DeepakRajasekaran/PowerDistributionBoard/docs/Technical_Assignment_2B.pdf

# Assignment 2b: 4S Battery Protection and Power Distribution Board

Author: Deepak Rajasekaran
Repository: https://github.com/DeepakRajasekaran/PowerDistributionBoard.git Document Revision: v1.1
Date: October 2026
EDA Suite: KiCad 9.0

## 1. Project Overview & Requirements

This report details the design and component selection for a 4S lithium-ion battery protection and power distribution board developed in KiCad. The board takes an unregulated battery input and routes power to two separate outputs:

1. Output 1 (Regulated 5V Rail): Provides a steady 5.0V at up to 3.0A continuous (15W) using a step-down buck switching regulator. This rail is intended for digital electronics such as flight controllers, single-board computers, and sensors. It features cycle-by-cycle overcurrent protection and automatic thermal shutdown.
2. Output 2 (Pass-Through Rail): An unregulated battery pass-through rated for 10.0A continuous (168W peak at full charge), designed to run high-power actuators, DC motors, or ESCs.

The board also includes front-end protection against short circuits, overcurrent, reverse battery connection, and inductive voltage spikes.

## 2. Power Architecture & Block Diagram

The board uses an input protection stage followed by two independent output branches. Power enters through an XT60 connector, passes through a primary 15A fuse, a bidirectional TVS diode, and a P-channel MOSFET reverse-polarity circuit. This creates an internal protected bus ( ).

From the internal bus, current splits into two separate fused paths:

The pass-through rail (Output 2) has its own 10A fuse and an 18V TVS clamp.
The 5V buck converter (Output 1) has a dedicated 3A branch fuse.

Fusing each output independently prevents a short circuit on the motor output from pulling down the 5V logic supply.

VSYS

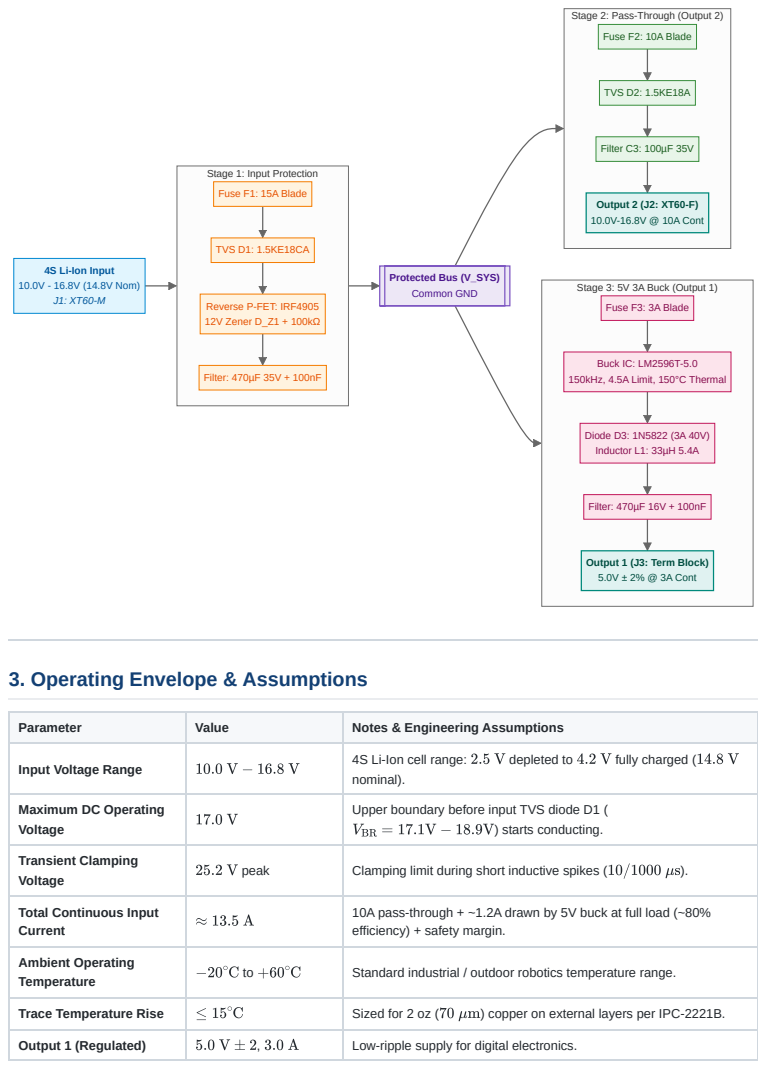
[picture p1: page 2]
Buck IC: LM2596T-5.0 150kHz, 4.5A Limit, 150°C Thermal; Diode D3: 1N5822 (3A 40V) Inductor L1: 33µH 5.4A; Filter: 470µF 16V + 100nF; TVS D2: 1.5KE18A; Filter C3: 100µF 35V; Output 2 (J2: XT60-F) 10.0V-16.8V @ 10A Cont; TVS D1: 1.5KE18CA; Reverse P-FET: IRF4905 12V Zener D_Z1 + 100kΩ; Filter: 470µF 35V + 100nF; Protected Bus (V_SYS) Common GND

Stage 2: Pass-Through (Output 2)
Fuse F2: 10A Blade

Stage 1: Input Protection
Fuse F1: 15A Blade

4S Li-Ion Input
10.0V - 16.8V (14.8V Nom)

Stage 3: 5V 3A Buck (Output 1)
Fuse F3: 3A Blade

Output 1 (J3: Term Block)
5.0V ± 2% @ 3A Cont

3. Operating Envelope & Assumptions

Parameter | Value | Notes & Engineering Assumptions

Input Voltage Range | 10.0 V − 16.8 V | 4S Li-Ion cell range: 2.5 V depleted to 4.2 V fully charged ( 14.8 V nominal).

Maximum DC Operating Voltage | 17.0 V | Upper boundary before input TVS diode D1 ( VBR = 17.1V − 18.9V ) starts conducting.

Transient Clamping Voltage | 25.2 V peak | Clamping limit during short inductive spikes ( 10/1000 μs ).

Total Continuous Input Current | ≈ 13.5 A | 10A pass-through + ~1.2A drawn by 5V buck at full load (~80% efficiency) + safety margin.

Ambient Operating Temperature | ∘C +60 ∘C −20 to | Standard industrial / outdoor robotics temperature range.

Trace Temperature Rise | ≤ 15 ∘C | Sized for 2 oz ( 70 μm ) copper on external layers per IPC-2221B.

Output 1 (Regulated) | 5.0 V ± 2 3.0 A , | Low-ripple supply for digital electronics.

Parameter | Value | Notes & Engineering Assumptions
Output 1 Ripple | < 30 mVp-p | Filtered using a 470µF electrolytic cap and a 100nF ceramic cap.
Output 2 (Pass-Through) | 10.0 V − 16.8 V , 10.0 A | High-power branch for DC motors and speed controllers.
Assembly Technology | 100% Through-Hole (THT) | Selected for easy assembly, field repairability, and sturdy mechanical mounting.

## 4. Circuit Design & Component Selection

### 4.1 Primary Fuse (F1)

I selected a 15A mini automotive blade fuse ( 0297015.WXNV ) mounted in a Keystone 3568 through-hole clip.

With both outputs running at full load, total continuous current is approximately 11.2A to 12.0A. A 15A rating provides roughly 25% to 30% margin over normal operating current, preventing nuisance blowing during startup surges while tripping quickly under short-circuit conditions. Blade fuses also offer very low resistance (around ), keeping voltage drop minimal.

### 4.2 Input Transient Suppressor (D1)

For overvoltage and transient suppression, the input uses a bidirectional TVS diode ( 1.5KE18CA ) rated for 1500W peak pulse power.

Standoff Voltage ( | ):
Breakdown Voltage ( | ): | ( | typical)
Clamping Voltage ( ): | at | peak
Because a 4S pack reaches | when fully charged, selecting an 18V TVS ensures that the diode stays
completely non-conducting during normal charging. If an inductive spike occurs from hot-plugging or motor switching, the diode clamps the spike well below the 35V/50V ratings of the capacitors and the 40V rating of the buck IC. If someone mistakenly connects a continuous 24V supply, D1 conducts heavily to ground and blows fuse F1, protecting the board.

### 4.3 Reverse-Polarity Protection (Q1, D_Z1, R_G1)

Connecting a battery backwards can instantly destroy electronics. While a standard series diode is the simplest solution, at 10A continuous it would drop 0.5V to 0.7V and dissipate:

This would generate excessive heat, require a bulky heatsink, and waste battery life.

Instead, I used an active high-side P-channel MOSFET switch ( IRF4905 in a TO-220 package). The IRF4905 has
an on-state resistance ( | ) of only | . At 10A continuous, conduction loss is:

The TO-220 package easily dissipates 2W in open air without a large heatsink.

Circuit Operation:

5 mΩ

VRWM | 15.3 V
VBR | 17.1 V − 18.9 V 18.0 V
VC | 25.2 V | 59.5 A

16.8 V

P = I × VF = 10 A × 0.6 V = 6.0 W

RDS(on) | 20 mΩ

P = I

| 2 × RDS(on) = (10 A)

2 × 0.020 Ω = 2.0 W

Normal Connection: When power is applied correctly, the gate is pulled to ground through a 100kΩ resistor
( | ). This gives a negative gate-to-source voltage ( | ), turning the MOSFET fully on.
Gate Protection: Because the maximum gate-to-source rating of the IRF4905 is | , a 12V Zener diode
( | : 1N4742A ) clamps | to -12V. This protects the thin gate oxide when the battery is at its 16.8V
maximum.
Reverse Connection: If the battery polarity is reversed, the gate is positive relative to the source (
), keeping the MOSFET off. The internal body diode is reverse-biased, completely blocking reverse current.

### 4.4 Stage 2: Pass-Through Output (F2, D2, C3)

The pass-through output (Output 2) connects through an independent 10A mini blade fuse ( F2 ).

Selective Coordination: Placing F2 on the pass-through channel ensures that if a motor shorts out, only F2 blows. The main 15A input fuse (F1) remains intact, keeping the 5V logic supply running without interruption. Inductive Clamp (D2): A unidirectional TVS diode ( 1.5KE18A ) across Output 2 absorbs inductive flyback voltage spikes caused by motor winding inductance when loads switch off suddenly.
Decoupling (C3): A 100µF 35V low-ESR electrolytic capacitor smooths voltage dips caused by motor startup surges.

### 4.5 Stage 3: Regulated 5V 3A Buck Converter (U1, D3, L1, C_OUT)

To supply 5.0V at up to 3.0A, I chose the Texas Instruments LM2596T-5.0 switching regulator in a 5-pin TO-220 package.

Switching Frequency: Operates at a fixed 150kHz, allowing the use of a reasonably small 33µH inductor while maintaining conversion efficiency above 80%.
Built-in Protection: The IC includes cycle-by-cycle current limiting set at 4.5A typical, as well as automatic thermal shutdown at 150°C.
Branch Fuse (F3): A 3A fast-acting blade fuse protects the buck stage against catastrophic regulator failure.
Duty Cycle Calculations: The duty cycle | of the buck regulator varies with input voltage:
Using | for the Schottky diode and | for the internal switch:
At nominal battery voltage ( | ):
At fully charged battery ( | ):
| During a 25V transient clamp:

Because the LM2596 can operate down to duty cycles below 5%, the closed-loop feedback maintains an exact 5.0V output across the entire input range and during transient voltage spikes.

Inductor Selection (L1): I selected a 33µH, 5.4A through-hole toroidal inductor ( 2100HT-330-V-RC ). The peak-topeak inductor ripple current at 14.8V nominal input is:

Peak inductor current at full 3A load is:

RG1 | VGS ≈ −VIN

±20V

DZ1 | VGS

VGS ≥ 0V

D

D =

VOUT + VD

VIN − VSAT + VD

VD = 0.45V | VSAT ≈ 1.1V

14.8V D ≈

5.0+0.45
14.8−1.1+0.45 = 5.45
14.15 ≈ 38.5

16.8V D ≈ 5.45
16.15 ≈ 33.7

D ≈ 5.45
24.35 ≈ 22.4

ΔIL =

(VIN − VOUT) ⋅ D

fsw ⋅ L1

=

(14.8 − 5.0) V × 0.385

150 kHz × 33 μH

≈ 0.76 Ap-p

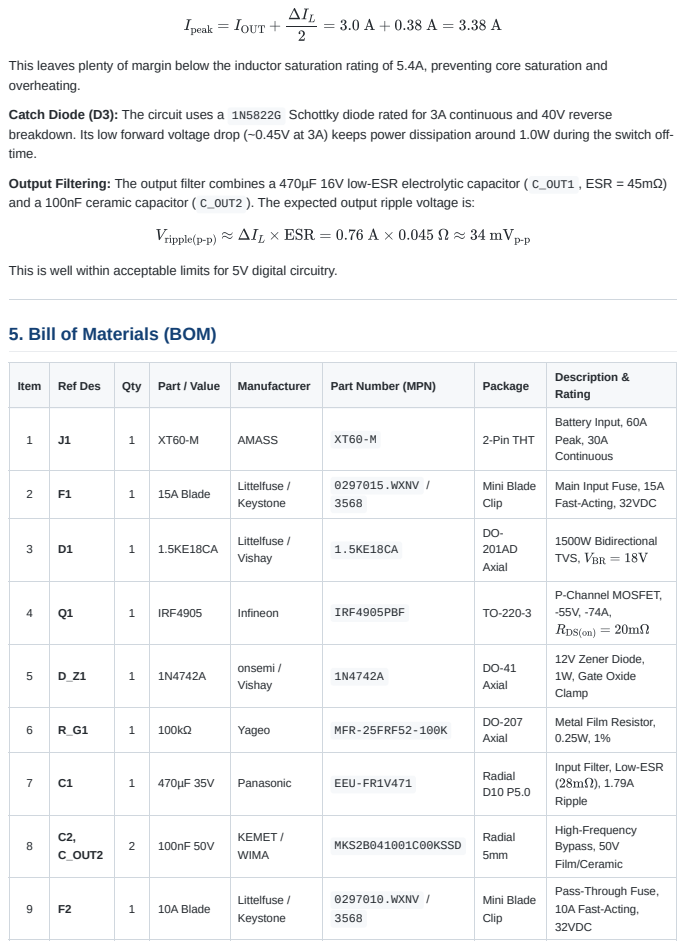
[picture p2: page 5]
Ipeak = IOUT +; ΔIL

This leaves plenty of margin below the inductor saturation rating of 5.4A, preventing core saturation and
overheating.

Catch Diode (D3): The circuit uses a 1N5822G Schottky diode rated for 3A continuous and 40V reverse
breakdown. Its low forward voltage drop (~0.45V at 3A) keeps power dissipation around 1.0W during the switch off-
time.

Output Filtering: The output filter combines a 470µF 16V low-ESR electrolytic capacitor ( C_OUT1 , ESR = 45mΩ)
and a 100nF ceramic capacitor ( C_OUT2 ). The expected output ripple voltage is:

Vripple(p-p) ≈ ΔIL × ESR = 0.76 A × 0.045 Ω ≈ 34 mVp-p

This is well within acceptable limits for 5V digital circuitry.

5. Bill of Materials (BOM)

Item | Ref Des | Qty | Part / Value | Manufacturer | Part Number (MPN) | Package | Description & Rating

1 | J1 | 1 | XT60-M | AMASS | XT60-M | 2-Pin THT | Battery Input, 60A Peak, 30A Continuous

2 | F1 | 1 | 15A Blade | Littelfuse / Keystone | 0297015.WXNV / 3568 | Mini Blade Clip | Main Input Fuse, 15A Fast-Acting, 32VDC

3 | D1 | 1 | 1.5KE18CA | Littelfuse / Vishay | 1.5KE18CA | DO-201AD Axial | 1500W Bidirectional TVS, VBR = 18V

4 | Q1 | 1 | IRF4905 | Infineon | IRF4905PBF | TO-220-3 | P-Channel MOSFET, -55V, -74A, RDS(on) = 20mΩ

5 | D_Z1 | 1 | 1N4742A | onsemi / Vishay | 1N4742A | DO-41 Axial | 12V Zener Diode, 1W, Gate Oxide Clamp

6 | R_G1 | 1 | 100kΩ | Yageo | MFR-25FRF52-100K | DO-207 Axial | Metal Film Resistor, 0.25W, 1%

7 | C1 | 1 | 470µF 35V | Panasonic | EEU-FR1V471 | Radial D10 P5.0 | Input Filter, Low-ESR ( 28mΩ ), 1.79A Ripple

8 | C2, C_OUT2 | 2 | 100nF 50V | KEMET / WIMA | MKS2B041001C00KSSD | Radial 5mm | High-Frequency Bypass, 50V Film/Ceramic

9 | F2 | 1 | 10A Blade | Littelfuse / Keystone | 0297010.WXNV / 3568 | Mini Blade Clip | Pass-Through Fuse, 10A Fast-Acting, 32VDC

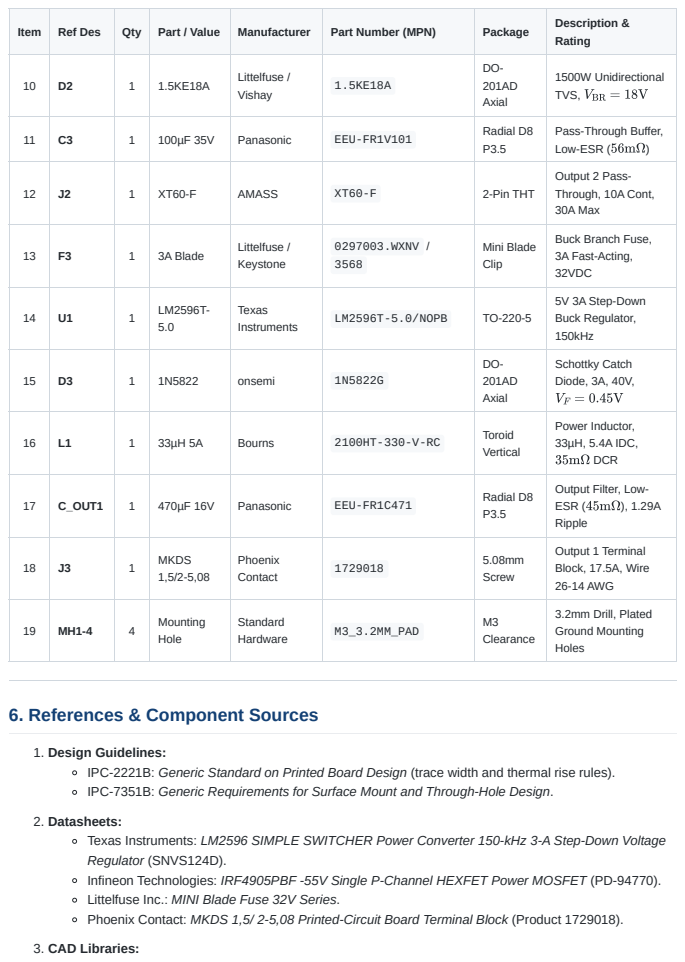
[picture p3: page 6]

Item | Ref Des | Qty | Part / Value | Manufacturer | Part Number (MPN) | Package | Description & Rating

10 | D2 | 1 | 1.5KE18A | Littelfuse / Vishay | 1.5KE18A | DO-201AD Axial | 1500W Unidirectional TVS, VBR = 18V

11 | C3 | 1 | 100µF 35V | Panasonic | EEU-FR1V101 | Radial D8 P3.5 | Pass-Through Buffer, Low-ESR ( 56mΩ )

12 | J2 | 1 | XT60-F | AMASS | XT60-F | 2-Pin THT | Output 2 Pass-Through, 10A Cont, 30A Max

13 | F3 | 1 | 3A Blade | Littelfuse / Keystone | 0297003.WXNV / 3568 | Mini Blade Clip | Buck Branch Fuse, 3A Fast-Acting, 32VDC

14 | U1 | 1 | LM2596T-5.0 | Texas Instruments | LM2596T-5.0/NOPB | TO-220-5 | 5V 3A Step-Down Buck Regulator, 150kHz

15 | D3 | 1 | 1N5822 | onsemi | 1N5822G | DO-201AD Axial | Schottky Catch Diode, 3A, 40V, VF = 0.45V

16 | L1 | 1 | 33µH 5A | Bourns | 2100HT-330-V-RC | Toroid Vertical | Power Inductor, 33µH, 5.4A IDC, 35mΩ DCR

17 | C_OUT1 | 1 | 470µF 16V | Panasonic | EEU-FR1C471 | Radial D8 P3.5 | Output Filter, Low-ESR ( ), 1.29A 45mΩ Ripple

18 | J3 | 1 | MKDS 1,5/2-5,08 | Phoenix Contact | 1729018 | 5.08mm Screw | Output 1 Terminal Block, 17.5A, Wire 26-14 AWG

19 | MH1-4 | 4 | Mounting Hole | Standard Hardware | M3_3.2MM_PAD | M3 Clearance | 3.2mm Drill, Plated Ground Mounting Holes

IPC-2221B: Generic Standard on Printed Board Design (trace width and thermal rise rules).
IPC-7351B: Generic Requirements for Surface Mount and Through-Hole Design.

Texas Instruments: LM2596 SIMPLE SWITCHER Power Converter 150-kHz 3-A Step-Down Voltage
Regulator (SNVS124D).
Infineon Technologies: IRF4905PBF -55V Single P-Channel HEXFET Power MOSFET (PD-94770).
Littelfuse Inc.: MINI Blade Fuse 32V Series.
Phoenix Contact: MKDS 1,5/ 2-5,08 Printed-Circuit Board Terminal Block (Product 1729018).

KiCad standard library footprints and 3D STEP models ( Connector_AMASS , Fuse , Diode_THT , Package_TO_SOT_THT , TerminalBlock_Phoenix , Inductor_THT ).

## 7. PCB Layout & Manufacturing Considerations

1. Layer Stack & Copper Weight: The board is designed as a standard 2-layer FR4 PCB with 1.6mm thickness and 2 oz ( ) outer copper. Using 2 oz copper significantly reduces trace resistance and heating on the high-current paths.
2. High-Current Routing:
The primary input path (from J1 through F1, Q1, and to the bus) and the pass-through output (F2 to J2) carry up to 10A to 15A.
Per IPC-2221B guidelines, these traces are sized between 3.5mm and 5.0mm in width, keeping conductor temperature rise well under 15°C.
Both the top and bottom layers feature solid copper ground pours tied together with ground stitching, providing a low-impedance return path for DC current and buck switching noise.
3. Thermal Management:
The TO-220 devices (MOSFET Q1 and buck IC U1) are positioned with ample clearance so their metal mounting tabs can dissipate heat into the air without crowding adjacent tall components. Through-hole pads on large copper pours use 4-spoke thermal relief connections to allow easy hand soldering with standard soldering irons.
4. Mechanical Layout & Usability: XT60 connectors are placed along board edges to allow easy battery mating.
The 5.08mm screw terminal block (J3) is oriented with its wire entry holes facing outward toward the PCB edge, making wire insertion and screw tightening straightforward once the board is mounted in an enclosure.
Four M3 mounting holes are placed at the board corners, plated to ground.

## 8. Verification & Pre-Power Testing Procedure

Before applying battery power to the assembled board, perform the following verification steps:

1. Visual & Continuity Inspection:
Check all solder joints for bridges, especially around the 5-pin TO-220 regulator and connector pins.
Measure resistance between | and GND with a multimeter. Ensure it reads | (no short
circuits).
Measure resistance between the 5V output and GND (should read | ).
2. Reverse Polarity Test:
Connect a bench power supply set to 14.8V with the current limit set to 100mA. Connect the supply in reverse polarity (positive to pin 2, negative to pin 1 of J1). Verify that the power supply shows 0mA current draw and that measures 0.0V.
3. Forward Voltage & Regulation Test: Connect the bench supply in correct polarity at 14.8V.
Measure Output 2 (J2): should match the input voltage minus the small | drop across Q1.
Measure Output 1 (J3): should read | .

70 μm

VSYS | > 100 kΩ

> 1 kΩ

VSYS

20 mΩ

5.00 V ± 0.1 V

Sweep the input voltage from 10.0V to 16.8V; confirm that Output 1 stays regulated at 5.0V with no oscillation.
