DeepakRajasekaran/PowerDistributionBoard/docs/battery_protection_board_tht_bom.csv

Item | Reference | Qty | Value | Description | Manufacturer | MPN | Package | Rating
1 | J1 | 1 | XT60-M_BATT_IN | DC Power Connector Male 2-Pin High Current Vertical THT | AMASS | XT60-M | AMASS_XT60-M_1x02_P7.20mm_Vertical | 60A Peak, 30A Continuous, 500V
2 | F1 | 1 | 15A Blade | Mini Automotive Blade Fuse 15A Fast-Acting with Keystone 3568 Clip | Littelfuse / Keystone | 0297015.WXNV (Fuse) / 3568 (Holder) | Fuseholder_Blade_Mini_Keystone_3568 | 15A, 32VDC, 1000A Interrupt
3 | D1 | 1 | 1.5KE18CA | TVS Diode Bidirectional 1500W 18V Axial Through-Hole | Littelfuse / Vishay | 1.5KE18CA | Diode_THT:D_DO-201AD_P15.24mm_Horizontal | 1500W, V_RWM=15.3V, V_BR=17.1V-18.9V, V_C=25.2V
4 | Q1 | 1 | IRF4905 | P-Channel Power MOSFET -55V -74A 20mOhm TO-220-3 | Infineon Technologies | IRF4905PBF | Package_TO_SOT_THT:TO-220-3_Vertical | V_DSS=-55V, I_D=-74A, R_DS(on)=0.02 Ohm, P_D=200W
5 | D_Z1 | 1 | 1N4742A_12V | Zener Diode 12V 1W 5% Axial DO-41 | onsemi / Vishay | 1N4742A | Diode_THT:D_DO-41_SOD81_P10.16mm_Horizontal | V_Z=12V, P_D=1.0W, I_ZT=21mA
6 | R_G1 | 1 | 100k | Metal Film Resistor 100k Ohm 1/4W 1% Axial | Yageo | MFR-25FRF52-100K | Resistor_THT:R_Axial_DIN0207_L6.3mm_D2.5mm_P10.16mm_Horizontal | 100k Ohm, 0.25W, +/-1%, 250V
7 | C1 | 1 | 470uF 35V | Aluminum Electrolytic Capacitor Radial Low-ESR 10x16mm | Panasonic | EEU-FR1V471 | Capacitor_THT:CP_Radial_D10.0mm_P5.00mm | 470uF, 35V, Low-ESR (0.028 Ohm), 1.79A Ripple
8 | C2, C_OUT2 | 2 | 100nF 50V | Film Capacitor 0.1uF 50V 5% 5mm Pitch Radial | WIMA / KEMET | MKS2B041001C00KSSD | Capacitor_THT:C_Rect_L7.2mm_W3.5mm_P5.00mm_FKS2_FKP2_MKS2_MKP2 | 0.1uF, 50VDC, +/-10%, Polyethylene/Ceramic
9 | F2 | 1 | 10A Blade | Mini Automotive Blade Fuse 10A Fast-Acting with Keystone 3568 Clip | Littelfuse / Keystone | 0297010.WXNV (Fuse) / 3568 (Holder) | Fuseholder_Blade_Mini_Keystone_3568 | 10A, 32VDC, 1000A Interrupt
10 | D2 | 1 | 1.5KE18A | TVS Diode Unidirectional 1500W 18V Axial Through-Hole | Littelfuse / Vishay | 1.5KE18A | Diode_THT:D_DO-201AD_P15.24mm_Horizontal | 1500W, V_RWM=15.3V, V_BR=17.1V-18.9V, V_C=25.2V
11 | C3 | 1 | 100uF 35V | Aluminum Electrolytic Capacitor Radial Low-ESR 8x11.5mm | Panasonic | EEU-FR1V101 | Capacitor_THT:CP_Radial_D8.0mm_P3.50mm | 100uF, 35V, Low-ESR (0.056 Ohm), 950mA Ripple
12 | J2 | 1 | XT60-F_OUT2_10A | DC Power Connector Female 2-Pin High Current Vertical THT | AMASS | XT60-F | Connector_AMASS:AMASS_XT60-F_1x02_P7.20mm_Vertical | 60A Peak, 30A Continuous, 500V
13 | F3 | 1 | 3A Blade | Mini Automotive Blade Fuse 3A Fast-Acting with Keystone 3568 Clip | Littelfuse / Keystone | 0297003.WXNV (Fuse) / 3568 (Holder) | Fuseholder_Blade_Mini_Keystone_3568 | 3A, 32VDC, 1000A Interrupt
14 | U1 | 1 | LM2596T-5.0 | Simple Switcher 3A Step-Down Voltage Regulator 5V Fixed TO-220-5 | Texas Instruments | LM2596T-5.0/NOPB | Package_TO_SOT_THT:TO-220-5_P3.4x3.7mm_StaggerOdd_Lead3.8mm_Vertical | V_IN=40V max, V_OUT=5.0V, I_OUT=3A, 150kHz, OC/Thermal
15 | D3 | 1 | 1N5822 | Schottky Barrier Rectifier Diode 40V 3A DO-201AD Axial | onsemi | 1N5822G | Diode_THT:D_DO-201AD_P15.24mm_Horizontal | V_RRM=40V, I_F(AV)=3A, V_F=0.45V at 3A
16 | L1 | 1 | 33uH 5A | Toroidal Power Inductor 33uH 5A Vertical THT | Bourns | 2100HT-330-V-RC | Inductor_THT:L_Toroid_Vertical_L16.0mm_W8.0mm_P7.62mm | 33uH +/-15%, I_DC=5.4A, DCR=0.035 Ohm
17 | C_OUT1 | 1 | 470uF 16V | Aluminum Electrolytic Capacitor Radial Low-ESR 8x11.5mm | Panasonic | EEU-FR1C471 | Capacitor_THT:CP_Radial_D8.0mm_P3.50mm | 470uF, 16V, Low-ESR (0.045 Ohm), 1.29A Ripple
18 | J3 | 1 | 5V_3A_TERM | PCB Terminal Block 2-Pin 5.08mm Pitch Horizontal Wire Entry | Phoenix Contact | 1729018 (MKDS 1,5/ 2-5,08) | TerminalBlock_Phoenix:TerminalBlock_Phoenix_MKDS-1,5-2-5.08_1x02_P5.08mm_Horizontal | 17.5A, 400V, Wire: 26-14 AWG
19 | MH1, MH2, MH3, MH4 | 4 | MountingHole_3.2mm | Mounting Hole M3 Isolated/Plated Pad 3.2mm Dia | Hardware | M3_3.2MM_HOLE | MountingHole:MountingHole_3.2mm_M3_Pad | Mechanical M3 Fastener Clearance
