DeepakRajasekaran/PowerDistributionBoard/docs/battery_protection_board_tht.step

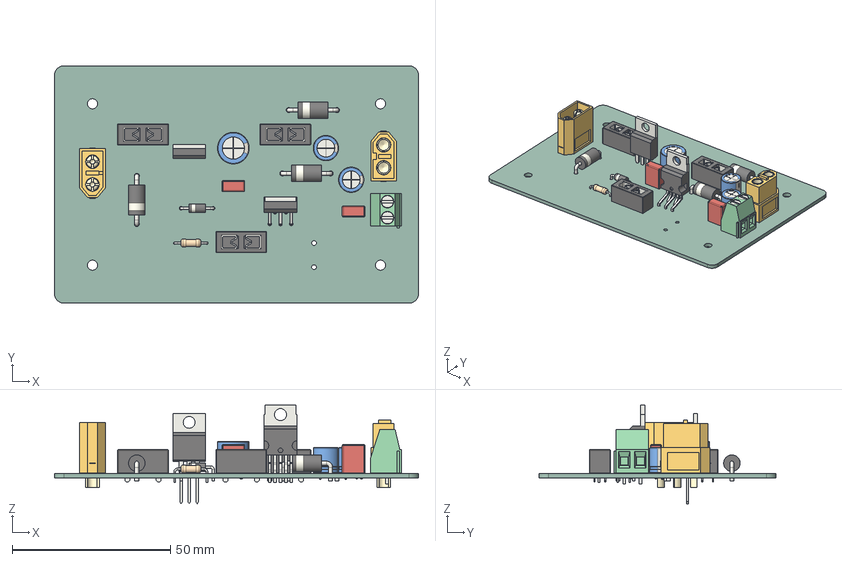
[picture p4: CAD file, 2026-10-22]
docs/battery_protection_board_tht.step
115.0 x 75.0 x 31.2 mm
D_DO-41_SOD81_P10.16mm_Horizontal
CP_Radial_D10.0mm_P5.00mm
D_DO-201AD_P15.24mm_Horizontal x 3
R_Axial_DIN0207_L6.3mm_D2.5mm_P10.16mm_Horizontal
CP_Radial_D8.0mm_P3.50mm x 2
AMASS_XT60-M_1x02_P7.2mm_Vertical
C_Rect_L7.2mm_W3.5mm_P5.00mm_FKS2_FKP2_MKS2_MKP2 x 2
AMASS_XT60-F_1x02_P7.2mm_Vertical
Fuseholder_Blade_Mini_Keystone_3568 x 3
TO-220-5_P3.4x3.7mm_StaggerOdd_Lead3.8mm_Vertical
TerminalBlock_Phoenix_MKDS-1,5-2-5.08_1x02_P5.08mm_Horizontal
TO-220-3_Vertical
battery_protection_board_tht_PCB
