DeepakRajasekaran/PowerDistributionBoard/docs/battery_protection_board_tht_schematic.pdf

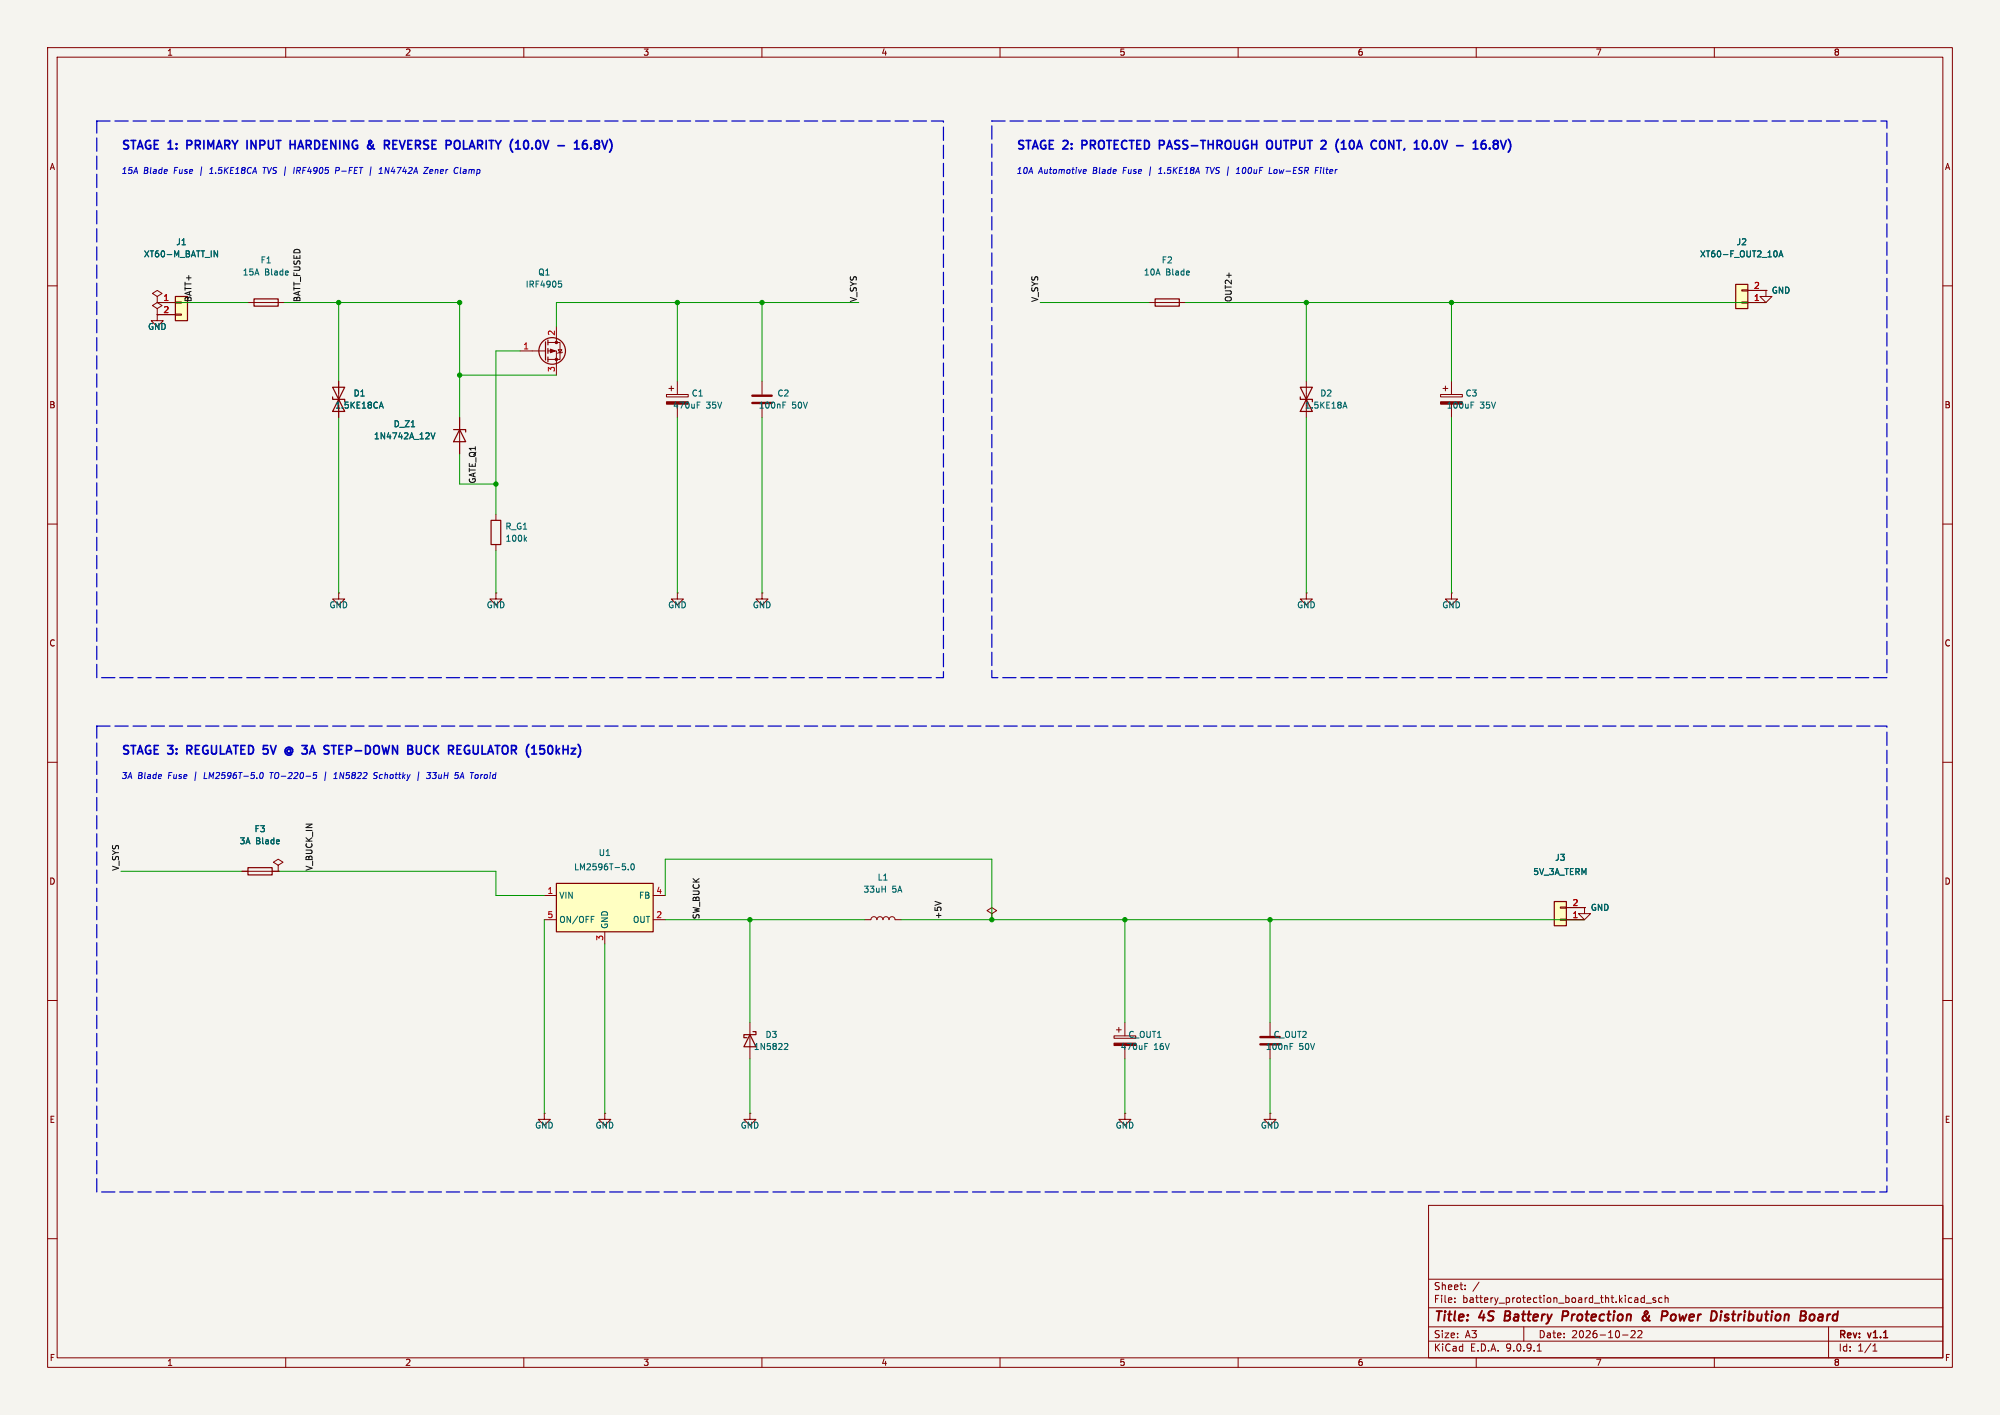
[picture p5: page 1]

Id: 1/1 Title: 4S Battery Protection & Power Distribution Board
