DeepakRajasekaran/PowerDistributionBoard/docs/battery_protection_board_tht_pcb.pdf

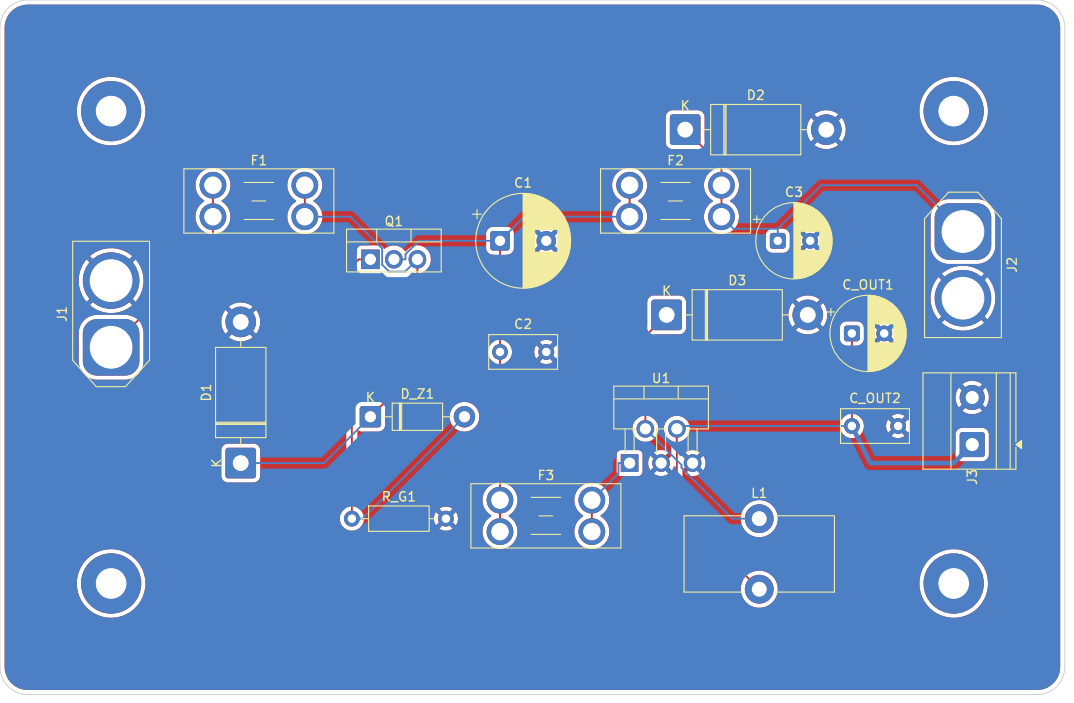
[picture p6: page 1]
