DeepakRajasekaran/PowerDistributionBoard/battery_protection_board_tht.kicad_pcb

## KiCad design battery_protection_board_tht.kicad_pcb (2026-10-22)

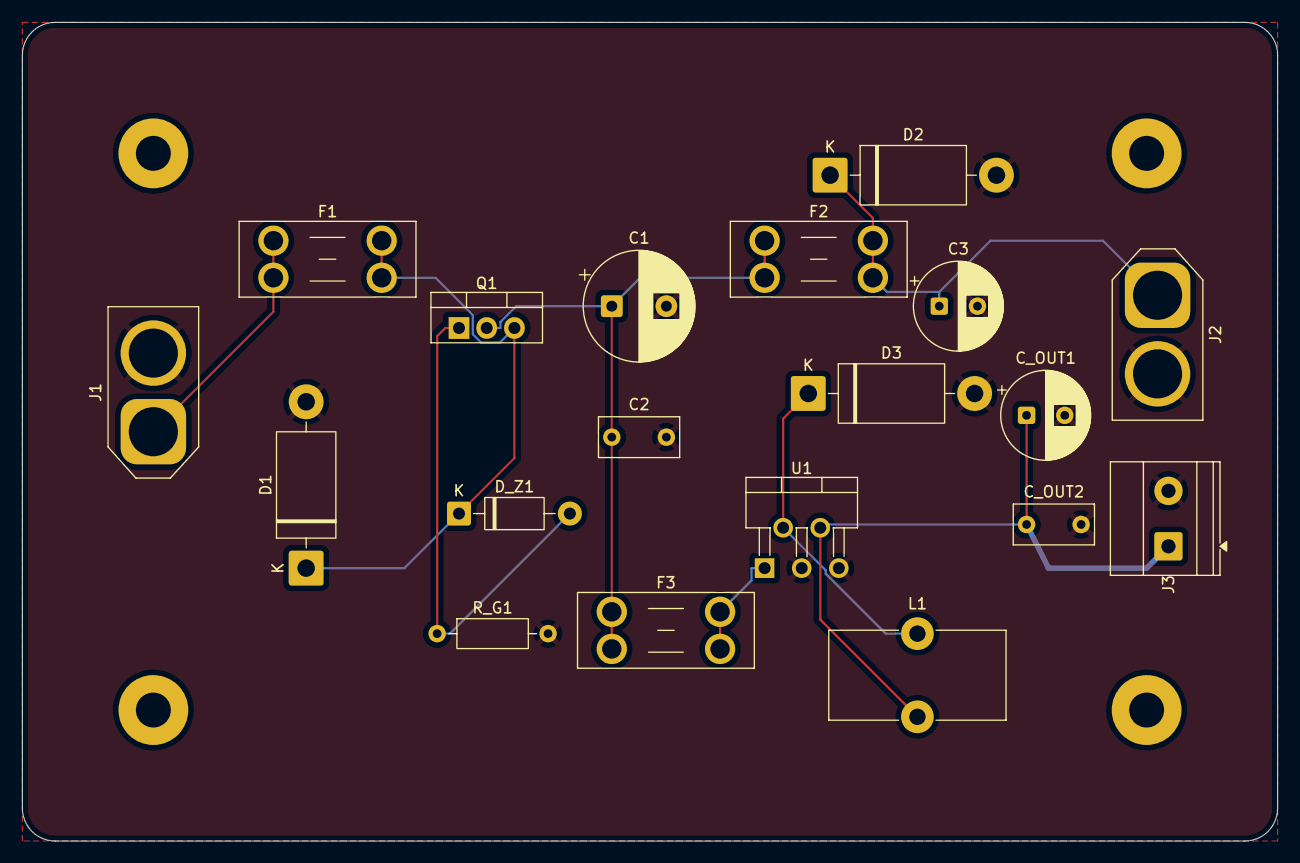
[picture p7: board battery_protection_board_tht.kicad_pcb from above]

Board: 2 copper layers, 115.0 x 75.0 mm, 23 parts (0 on the bottom side), 9 nets.

Parts:
C1: 470uF 35V; CP_Radial_D10.0mm_P5.00mm
C2: 100nF 50V; C_Rect_L7.2mm_W3.5mm_P5.00mm_FKS2_FKP2_MKS2_MKP2
C3: 100uF 35V; CP_Radial_D8.0mm_P3.50mm
C_OUT1: 470uF 16V; CP_Radial_D8.0mm_P3.50mm
C_OUT2: 100nF 50V; C_Rect_L7.2mm_W3.5mm_P5.00mm_FKS2_FKP2_MKS2_MKP2
D1: 1.5KE18CA; D_DO-201AD_P15.24mm_Horizontal
D2: 1.5KE18A; D_DO-201AD_P15.24mm_Horizontal
D3: 1N5822; D_DO-201AD_P15.24mm_Horizontal
D_Z1: 1N4742A_12V; D_DO-41_SOD81_P10.16mm_Horizontal
F1: 15A Blade; Fuseholder_Blade_Mini_Keystone_3568
F2: 10A Blade; Fuseholder_Blade_Mini_Keystone_3568
F3: 3A Blade; Fuseholder_Blade_Mini_Keystone_3568
J1: XT60-M_BATT_IN; AMASS_XT60-M_1x02_P7.20mm_Vertical
J2: XT60-F_OUT2_10A; AMASS_XT60-F_1x02_P7.20mm_Vertical
J3: 5V_3A_TERM; TerminalBlock_Phoenix_MKDS-1,5-2-5.08_1x02_P5.08mm_Horizont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
L1: 33uH 5A; L_Toroid_Vertical_L16.0mm_W8.0mm_P7.62mm
MH1, MH2, MH3, MH4: MountingHole_3.2mm; MountingHole_3.2mm_M3_Pad
Q1: IRF4905; TO-220-3_Vertical
R_G1: 100k; R_Axial_DIN0207_L6.3mm_D2.5mm_P10.16mm_Horizontal
U1: LM2596T-5.0; TO-220-5_P3.4x3.7mm_StaggerOdd_Lead3.8mm_Vertical

Connections:
+5V: C_OUT1.1, C_OUT2.1, J3.1, L1.2, U1.4
BATT+: F1.1, J1.1
BATT_FUSED: D1.1, D_Z1.1, F1.2, Q1.3
GATE_Q1: D_Z1.2, Q1.1, R_G1.1
GND: C1.2, C2.2, C3.2, C_OUT1.2, C_OUT2.2, D1.2, D2.2, D3.2, J1.2, J2.2, J3.2, R_G1.2, U1.3, U1.5
OUT2+: C3.1, D2.1, F2.2, J2.1
SW_BUCK: D3.1, L1.1, U1.2
V_BUCK_IN: F3.2, U1.1
V_SYS: C1.1, C2.1, F2.1, F3.1, Q1.2
